yavuzselimuyaner/stm32-uart-mouse/Core/Inc/main.h

#define B1_Pin GPIO_PIN_13
#define B1_GPIO_Port GPIOC
#define BTN_UP_Pin GPIO_PIN_0
#define BTN_UP_GPIO_Port GPIOA
#define BTN_DOWN_Pin GPIO_PIN_1
#define BTN_DOWN_GPIO_Port GPIOA
#define USART_TX_Pin GPIO_PIN_2
#define USART_TX_GPIO_Port GPIOA
#define USART_RX_Pin GPIO_PIN_3
#define USART_RX_GPIO_Port GPIOA
#define BTN_LEFT_Pin GPIO_PIN_4
#define BTN_LEFT_GPIO_Port GPIOA
#define LD2_Pin GPIO_PIN_5
#define LD2_GPIO_Port GPIOA
#define BTN_CLICK_Pin GPIO_PIN_10
#define BTN_CLICK_GPIO_Port GPIOB
#define BTN_RIGHT_Pin GPIO_PIN_8
#define BTN_RIGHT_GPIO_Port GPIOA
#define TMS_Pin GPIO_PIN_13
#define TMS_GPIO_Port GPIOA
#define TCK_Pin GPIO_PIN_14
#define TCK_GPIO_Port GPIOA
#define SWO_Pin GPIO_PIN_3
#define SWO_GPIO_Port GPIOB
